autotel/prototype-physical-modular/datasheets and references/F1752AGIJYUVVP0.png

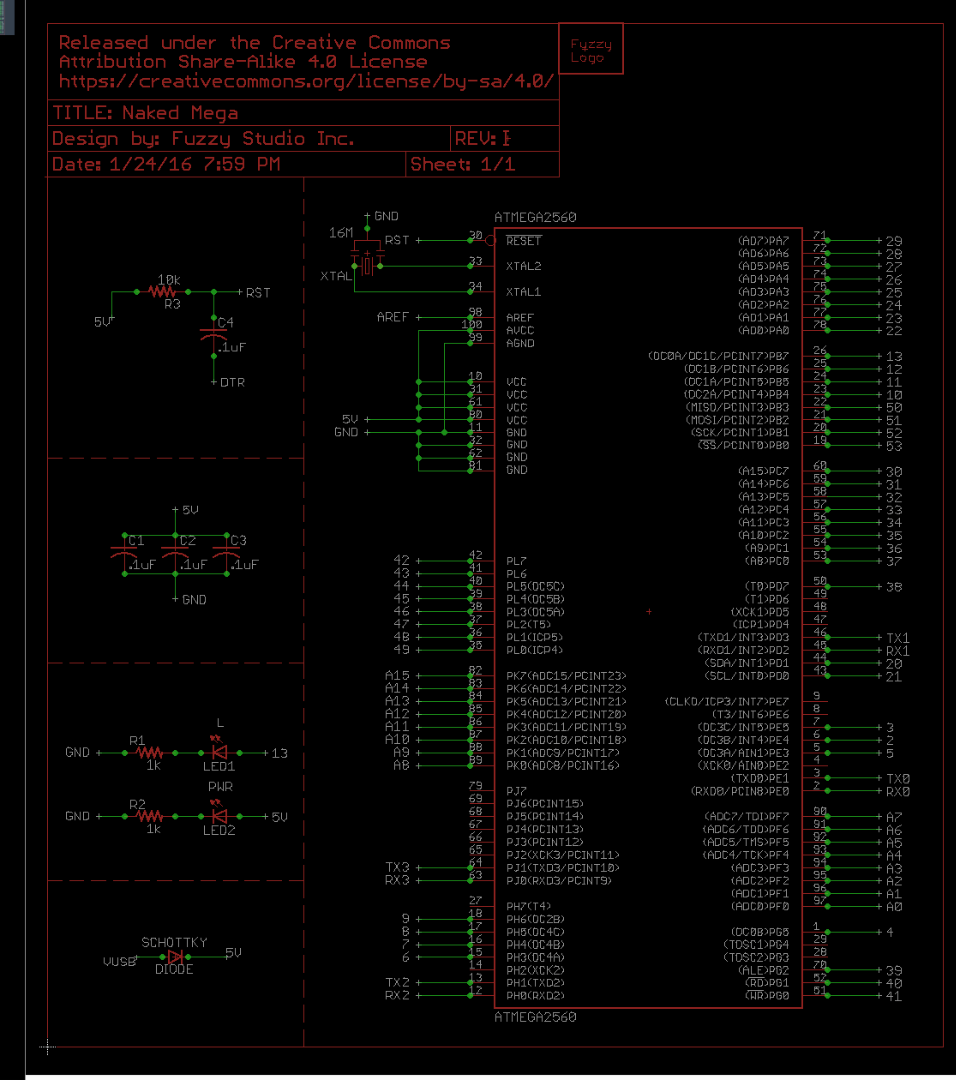
datasheets and references/F1752AGIJYUVVP0.png
