autotel/prototype-physical-modular/3d models/WS2812_RGB_LED_updated.stp

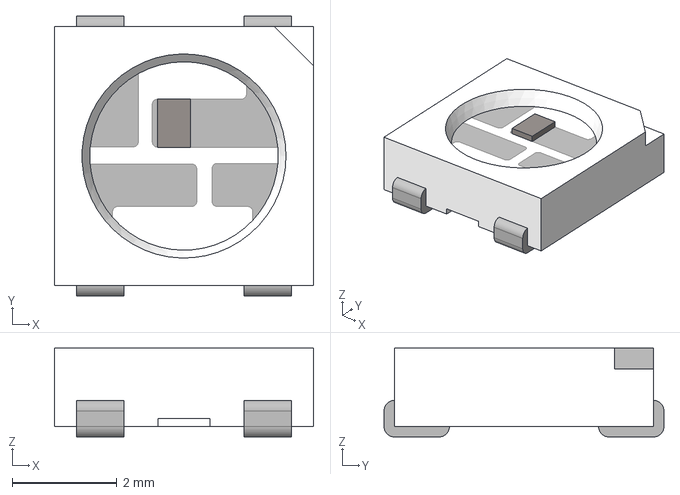
[picture p2: CAD file, 2017-10-20]
3d models/WS2812_RGB_LED_updated.stp
4.95 x 5.35 x 1.70 mm
