autotel/prototype-physical-modular/datasheets and references/under with raspi.dxf

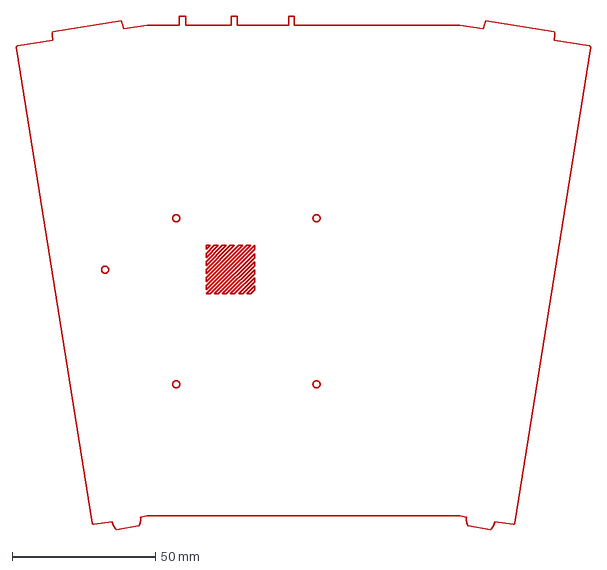
[picture p3: CAD file, 2017-09-11]
datasheets and references/under with raspi.dxf
200.6 x 179.2 mm
