autotel/prototype-physical-modular/enclosure/print/translucid.dxf

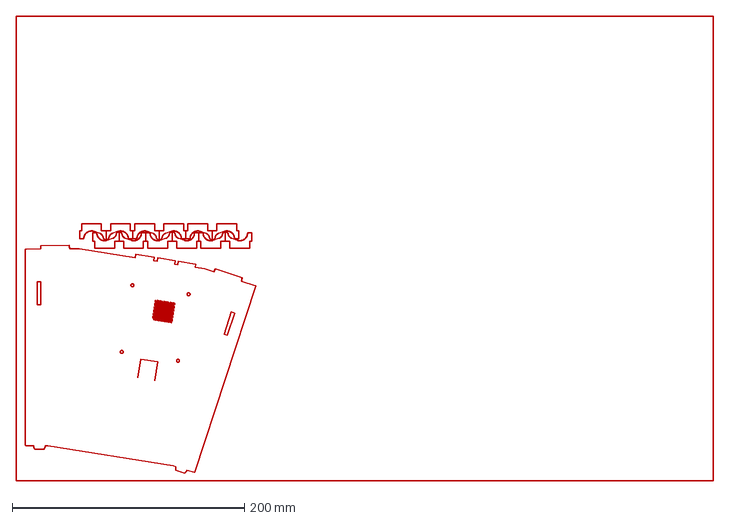
[picture p4: CAD file, 2018-03-19]
enclosure/print/translucid.dxf
600.0 x 400.0 mm
