autotel/prototype-physical-modular/enclosure/simpler enclosure 2017-11-23.dxf

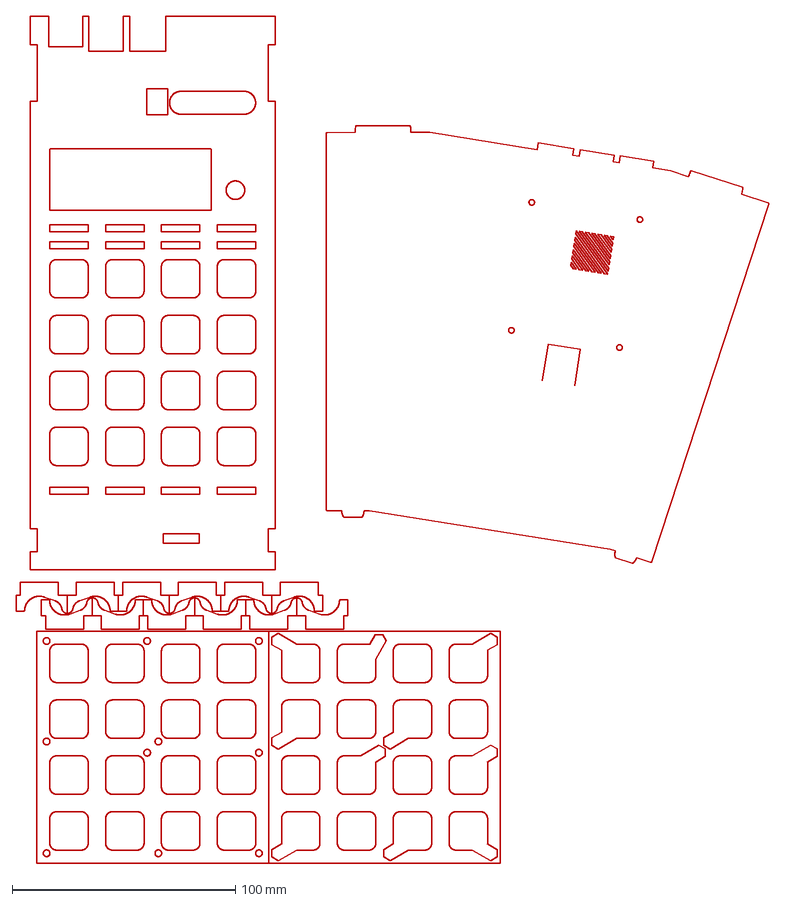
[picture p5: CAD file, 2018-03-19]
enclosure/simpler enclosure 2017-11-23.dxf
336.8 x 379.1 mm
