autotel/prototype-physical-modular/prints/prototype-physical modular-F.Cu.dxf

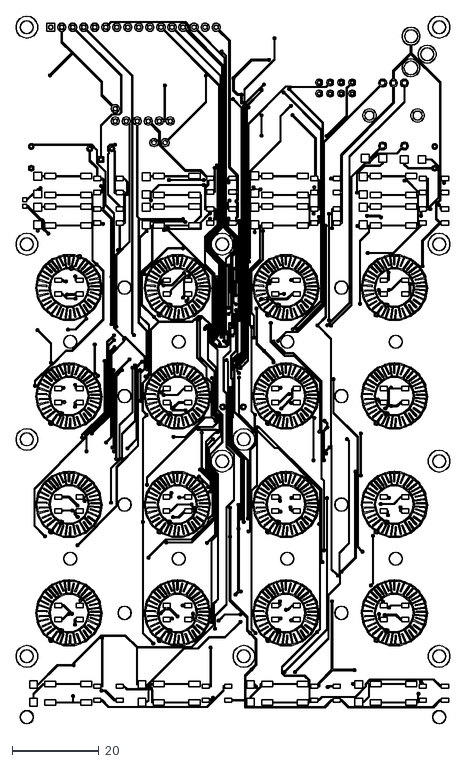
[picture p6: CAD file, 2018-03-19]
prints/prototype-physical modular-F.Cu.dxf
99.9 x 163.0
