autotel/prototype-physical-modular/datasheets and references/Raspberry-Pi-3B-V1.2-Mechanical.dxf

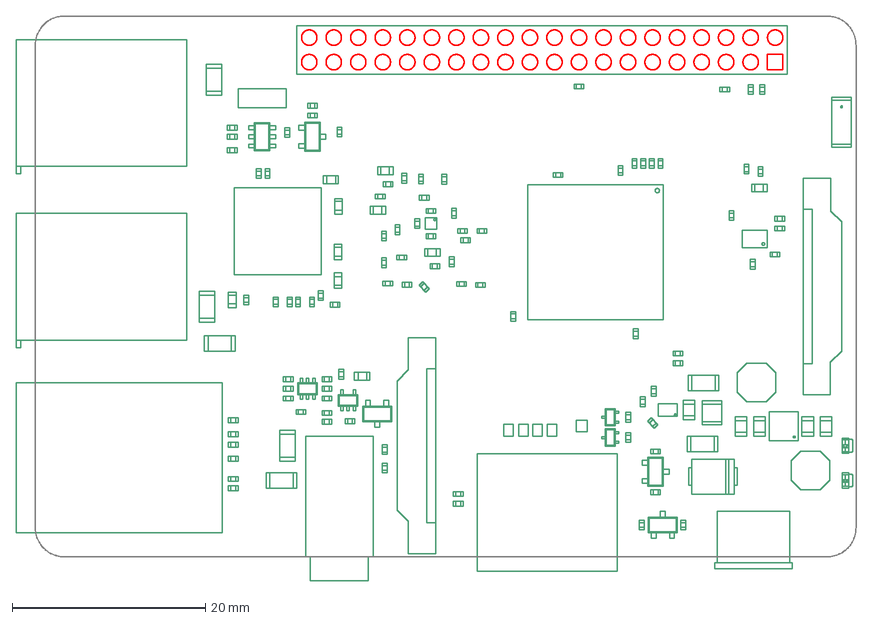
[picture p7: CAD file, 2017-06-26]
datasheets and references/Raspberry-Pi-3B-V1.2-Mechanical.dxf
87.0 x 58.5 mm
