autotel/prototype-physical-modular/enclosure/print/knob.stl

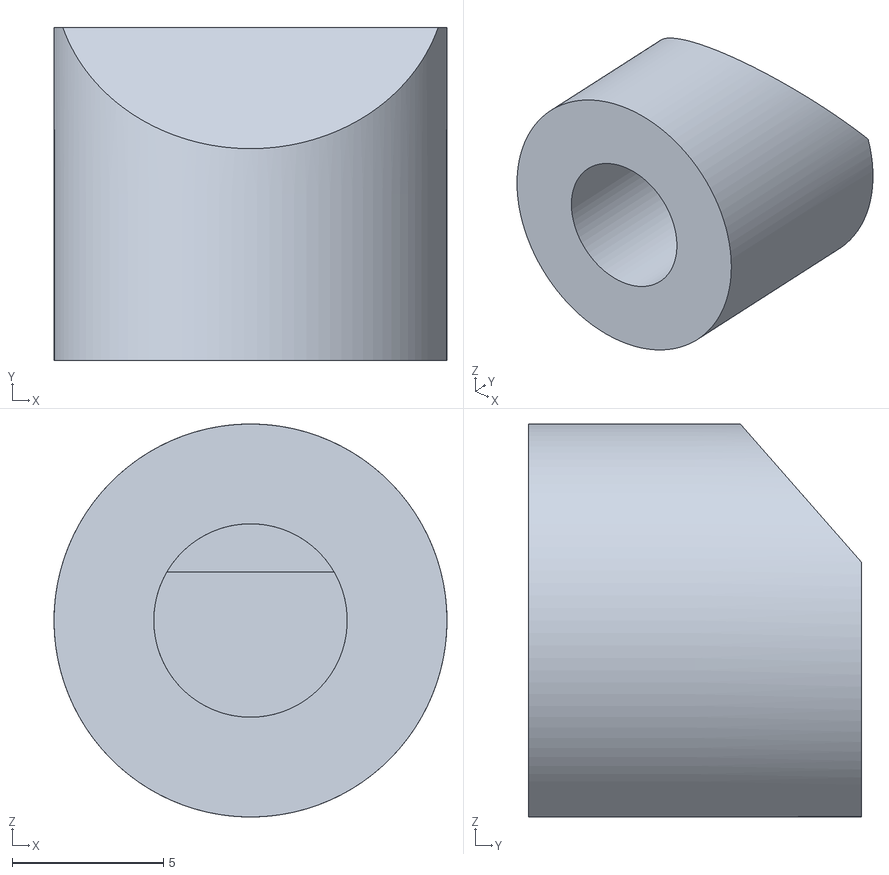
[picture p8: CAD file, 2018-03-19]
enclosure/print/knob.stl
13.0 x 11.0 x 13.0
