autotel/prototype-physical-modular/prints/prototype-physical modular-Edge.Cuts.dxf

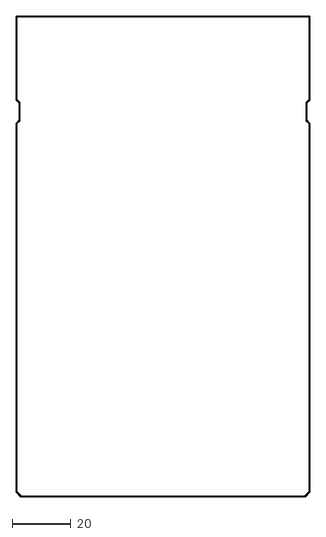
[picture p9: CAD file, 2018-03-19]
prints/prototype-physical modular-Edge.Cuts.dxf
100.2 x 164.1
