autotel/prototype-physical-modular/datasheets and references/SKQGWith stem type pad sizes.dxf

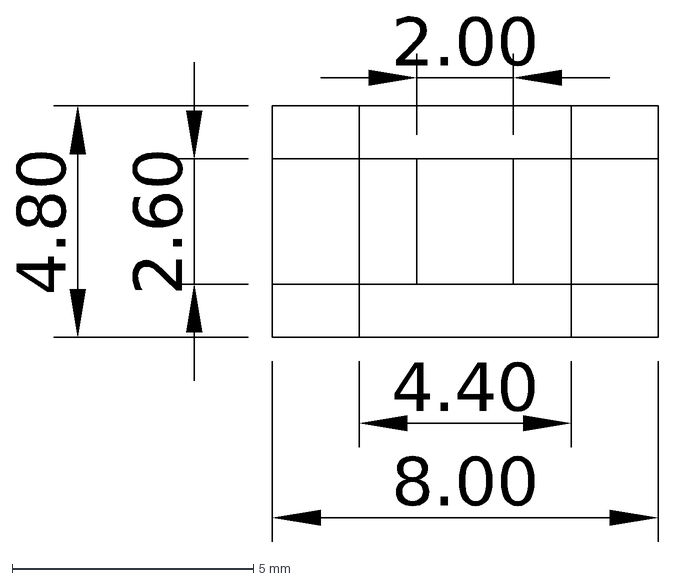
[picture p10: CAD file, 2017-06-26]
datasheets and references/SKQGWith stem type pad sizes.dxf
2.00
8.00
4.80
2.60
4.40
