autotel/prototype-physical-modular/enclosure/print/opaque.dxf

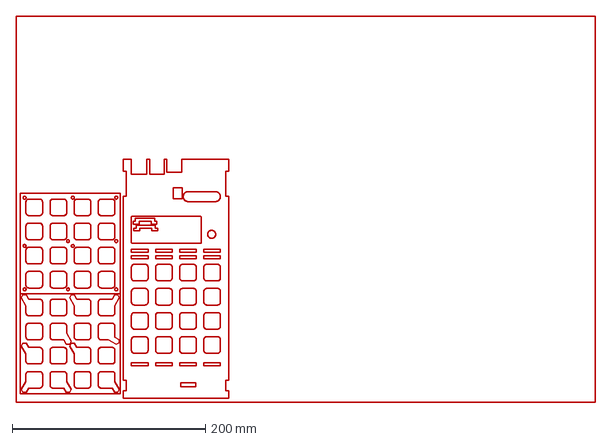
[picture p11: CAD file, 2018-03-19]
enclosure/print/opaque.dxf
600.0 x 400.0 mm
