autotel/prototype-physical-modular/prints/prototype-physical modular-B.Cu.dxf

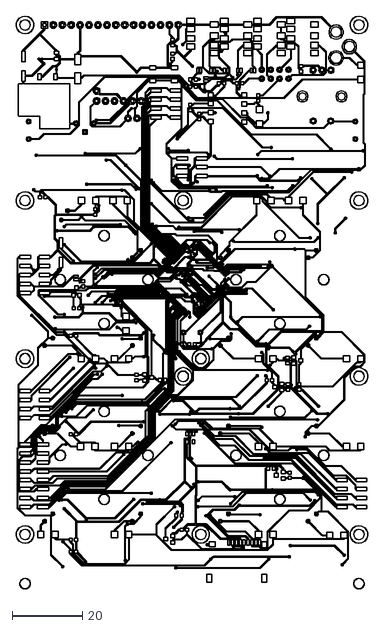
[picture p12: CAD file, 2018-03-19]
prints/prototype-physical modular-B.Cu.dxf
99.9 x 163.0
