autotel/prototype-physical-modular/enclosure/print/opaque_front.dxf

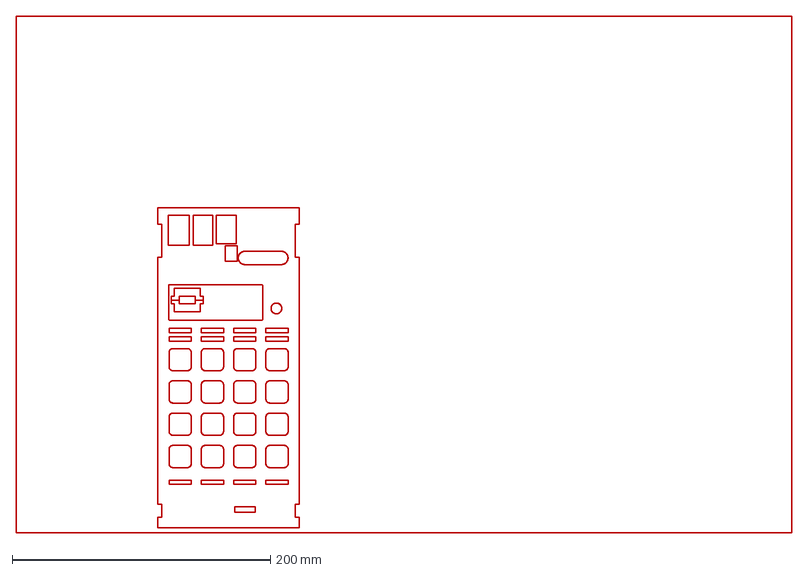
[picture p13: CAD file, 2018-03-19]
enclosure/print/opaque_front.dxf
600.0 x 400.0 mm
