autotel/prototype-physical-modular/(list of files, cad)

Other CAD files:
3d models/WS2812_RGB_LED_Updated.igs
3d models/WS2812b Updated.prt
3d models/WS2812b updated.x_t
datasheets and references/raspi.3dm
enclosure/OldVersions/knob.0003.ipt
enclosure/acrylic bending curve calculation.3dm
enclosure/knob.ipt
prints/prototype-physical modular-B.Mask.dxf
prints/prototype-physical modular-F.Mask.dxf
prints/prototype-physical modular-F.SilkS.dxf
