autotel/prototype-physical-modular/enclosure/cotizacion joaquin.pdf

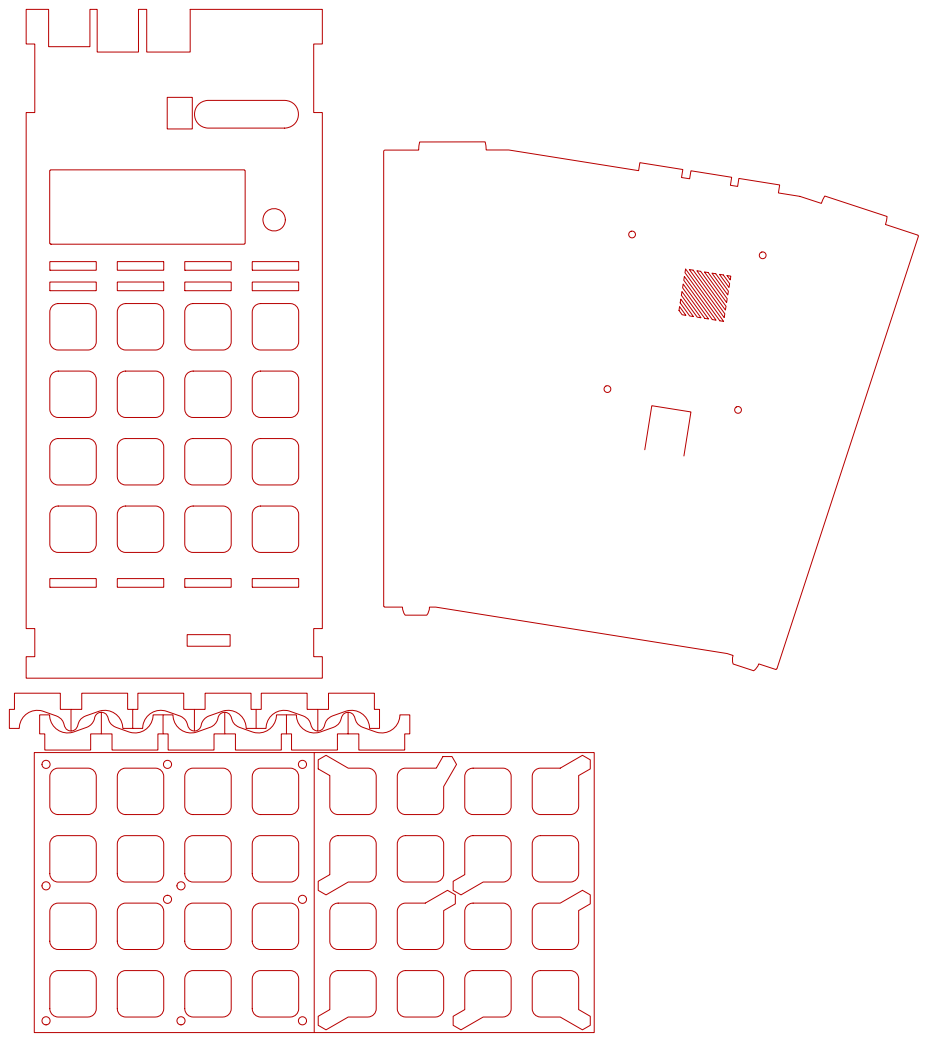
[picture p14: page 1]
