autotel/prototype-physical-modular/enclosure/simpler enclosure-cotizacion.pdf

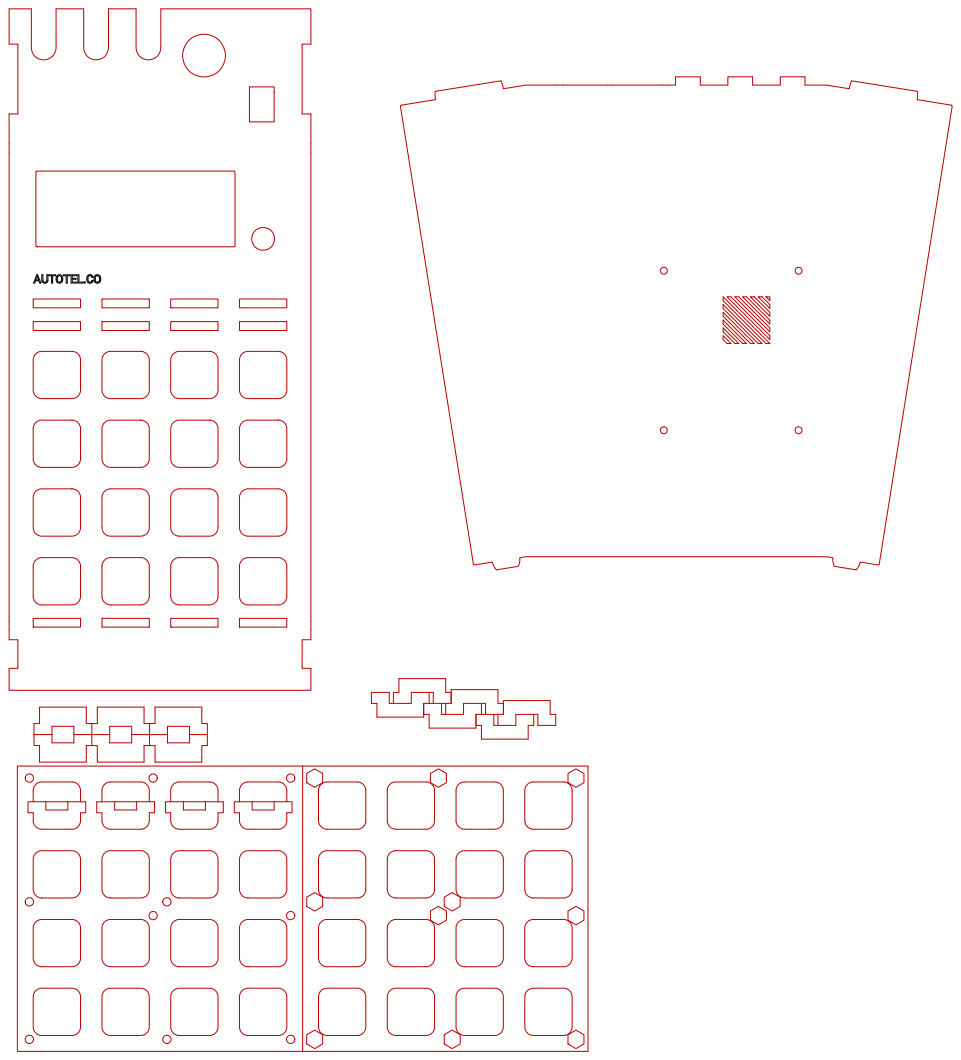
[picture p15: page 1]
