autotel/prototype-physical-modular/(list of files, drawings)

Other design files:
353-122283914449.dsn
prototype-physical modular.dsn
specctra-305-107207415804.dsn
unrouted.dsn
