autotel/prototype-physical-modular/prototype-physical modular.kicad_pcb

## KiCad design prototype-physical modular.kicad_pcb (2018-03-19)

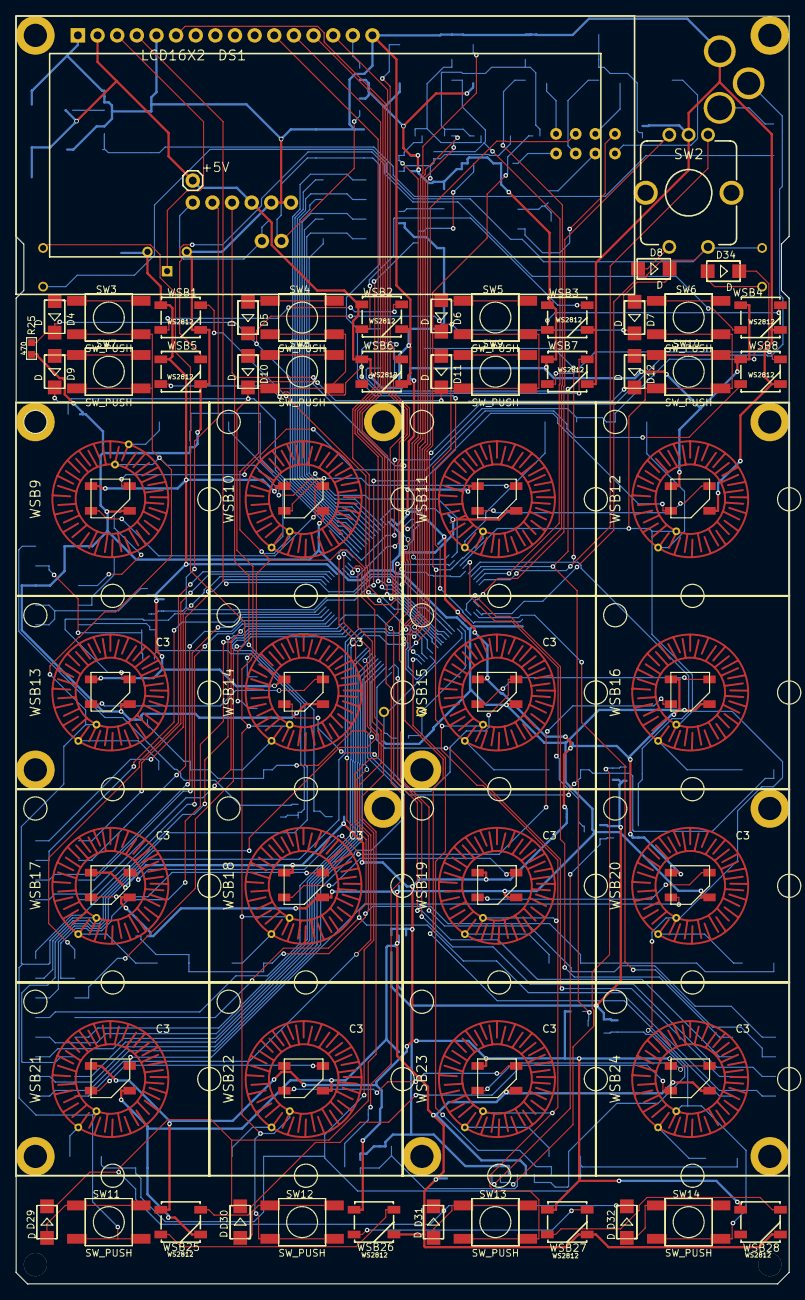
[picture p16: board prototype-physical modular.kicad_pcb from above]

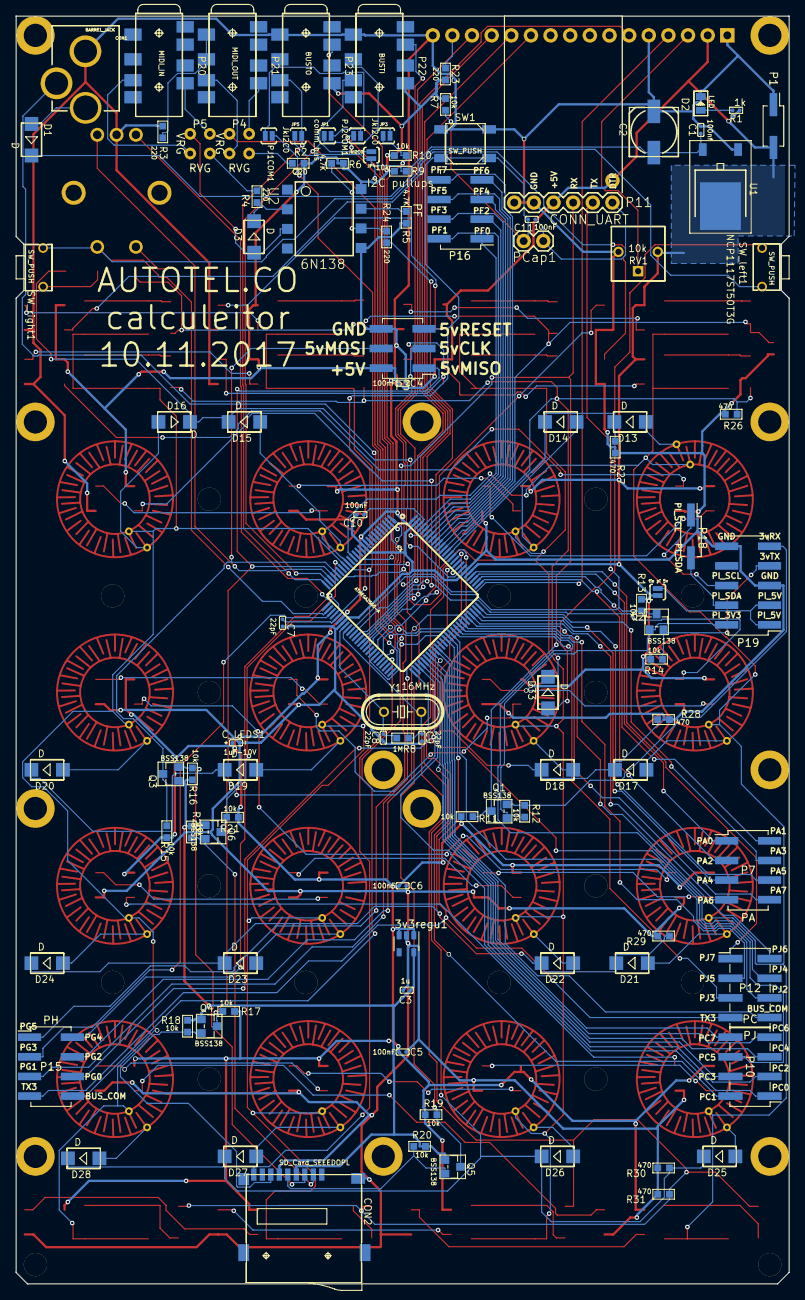
[picture p17: board prototype-physical modular.kicad_pcb from below]

Board: 2 copper layers, 100.0 x 164.0 mm, 188 parts (103 on the bottom side), 168 nets.

Parts:
3v3regu1: TLV70233DBV; SOT-23-5
+5V: >VALUE; 1X01
C1: 100nf; C0402
C2: Aluminum 47uF-25V; ELECTRO-SMD-C-6MM
C3: 1u; C0402
C4, C5, C6, C10, C11: 100nF; C0402
C7, C8, C9: 22pF; C0402
CON1: BARREL_JACK; POWER_JACK_PTH_LOCK
CON2: SD_Card_SEEEDOPL; MICRO-SD9+4P-SMD-16.1X14.5X1.85MM
C_LEDS1: 1uF-10V; C0402_electrolitic
D1, D3, D4, D5, D6, D7, D8, D9, D10, D11, D12, D13, D14, D15, D16, D17, D18, D19, D20, D21, D22, D23, D24, D25, D26, D27, D28, D29, D30, D31, D32, D33, D34: D; DO-214AC
D2: LED; LED-0805
DS1: LCD16X2; LCD-16X2
H1, H2, H3, H4, H5, H6, H7, H8, H9, H10, H11, H12, H26, H27, H28, H29, H30: hole; hole_no-copper
H13, H14, H15, H16, H18, H20, H21, H22, H23, H24: hole; hole_with-copper
IC1: ATMEGA2560-A; TQFP100
JP1: comm_bus; PAD-JUMPER-2-NO_YES_SILK
JP2: tie pi 5v; PAD-JUMPER-2-NO_YES_SILK
JP3, JP4, JP5: JkI2C0; PAD-JUMPER-2-NO_YES_SILK
P1: POWER; Pin_Header_Straight_2x01_Pitch2.54mm_SMD
P3: SPI; Pin_Header_Straight_2x03_Pitch2.54mm_SMD
P4, P5: CONN_02X02; xjump
P7: PA; Pin_Header_Straight_2x04_Pitch2.54mm_SMD
P10: PC; Pin_Header_Straight_2x04_Pitch2.54mm_SMD
P11: CONN_UART; 1X06
P12: PJ; Pin_Header_Straight_2x04_Pitch2.54mm_SMD
P15: PH; Pin_Header_Straight_2x04_Pitch2.54mm_SMD
P16: PF; Pin_Header_Straight_2x04_Pitch2.54mm_SMD
P18: 3VI2C; Pin_Header_Straight_2x01_Pitch2.54mm_SMD
P19: PIGPIO; Pin_Header_Straight_2x05_Pitch2.54mm_SMD-raspi
P20: MIDI_IN; AUDIO8P-SMD-3.5-14.5X6.1X4.0MM
P21: MIDI_OUT; AUDIO8P-SMD-3.5-14.5X6.1X4.0MM
P22: BUSTI; AUDIO8P-SMD-3.5-14.5X6.1X4.0MM
P23: BUSTO; AUDIO8P-SMD-3.5-14.5X6.1X4.0MM
PCap1: CONN_01X02; 1X02
PJ1COM1, PJ2COM1: Jumper_NO_Small; PAD-JUMPER-2-NO_YES_SILK
Q1, Q2, Q3, Q4, Q5, Q6: BSS138; SOT-23
R1: 1k; R0402
R2, R3, R4, R23, R24: 220; R0603
R5, R6: 4.7K; R0603
R7, R9, R10, R11, R12, R13, R14, R15, R16, R17, R18, R19, R20, R21, R22: 10k; R0603
R8: 1M; R0603
R25, R26, R27, R28, R29, R30, R31: 470; R0603
RV1: 10k; trimpot
SW1: SW_PUSH; SW4-SMD-5.2X5.2X1.5MM
SW2: ROTARY_ENCODER_SWITCH; ENCODER_LED_2
SW3, SW4, SW5, SW6, SW7, SW8, SW9, SW10, SW11, SW12, SW13, SW14: SW_PUSH; SW4-SMD-6.0X6.0X5.0MM
SW_left1: SW_PUSH; SW2-5.0-6.0X3.0X4.3MM
SW_right1: SW_PUSH; SW2-5.0-6.0X3.0X4.3MM
U1: NCP1117ST50T3G; TO-252
U2: 6N138; 8-SMD
WSB1, WSB2, WSB3, WSB4, WSB5, WSB6, WSB7, WSB8, WSB25, WSB26, WSB27, WSB28: WS2812; WS2812B
WSB9, WSB10, WSB11, WSB12, WSB13, WSB14, WSB15, WSB16, WSB17, WSB18, WSB19, WSB20, WSB21, WSB22, WSB23, WSB24: WS2812_BUTTON; ws2812_buttonPad
Y1: 16MHz; HC49US

Connections:
+3V3: 3v3regu1.5, C3.1, CON2.4, Q3.1, Q4.1, Q5.1, Q6.1, R16.1, R18.1, R20.1, R22.1
+5V: 3v3regu1.1, 3v3regu1.3, +5V.1, C4.1, C5.1, C6.1, C_LEDS1.1, DS1.2, IC1.10, IC1.31, IC1.80, IC1.100, JP2.2, P1.2, P3.2, P11.3, P22.4, P23.4, R1.1, R2.1, R6.2, R7.1, R9.1, R10.1, R11.2, R13.2, R15.2, R17.2, R19.2, R21.2, R23.1, RV1.1, U1.2, U2.8, WSB1.1, WSB2.1, WSB3.1, WSB4.1, WSB5.1, WSB6.1, WSB7.1, WSB8.1, WSB9.1, WSB10.1, WSB11.1, WSB12.1, WSB13.1, WSB14.1, WSB15.1, WSB16.1, WSB17.1, WSB18.1, WSB19.1, WSB20.1, WSB21.1, WSB22.1, WSB23.1, WSB24.1, WSB25.1, WSB26.1, WSB27.1, WSB28.1
/3VSD_CS: CON2.2, Q6.2, R22.2
/3vRX0: P19.9, Q1.2, R12.2
/3vSPI_MISO: CON2.7, Q4.2, R18.2
/3vSPI_MOSI: CON2.3, Q3.2, R16.2
/3vSPI_SCK: CON2.5, Q5.2, R20.2
/3vTX0: P19.7, Q2.2, R14.2
/5VSD_CLK: IC1.20, P3.3, Q5.3, R19.1
/5VSD_CS: IC1.19, Q6.3, R21.1
/5VSD_MISO: IC1.22, P3.1, Q4.3, R17.1
/5VSD_MOSI: IC1.21, P3.4, Q3.3, R15.1
/BUSTI_CONN: IC1.82, P22.6
/BUSTO_CONN: IC1.14, P23.6
/BUS_COM: IC1.63, JP1.1, JP3.2, P12.8, P15.8, P22.2
/BUS_COM_B: JP1.2, P23.2, PJ1COM1.1, PJ2COM1.1
/BUS_TI: IC1.24, JP4.2, P22.3
/BUS_TO: IC1.25, JP5.2, P23.3
/DTR: C11.1, P11.6, PCap1.2
/ENCA: IC1.23, SW2.A
/ENCC: IC1.26, SW2.B
/LCD0: DS1.4, IC1.35
/LCD1: DS1.6, IC1.36
/LCD2: DS1.11, IC1.37
/LCD3: DS1.12, IC1.38
/LCD4: DS1.13, IC1.39
/LCD5: DS1.14, IC1.40
/MIDI_IN_RX_PRE: D3.+, P5.3, U2.3
/MIDI_OUT_TX: IC1.46, P4.3
/MIDI_RX: IC1.45, R24.2
/MUXAX0: IC1.15, SW3.2, SW7.2, SW11.2, WSB9.6, WSB13.6, WSB17.6, WSB21.6
/MUXAX1: IC1.16, SW4.2, SW8.2, SW12.2, WSB10.6, WSB14.6, WSB18.6, WSB22.6
/MUXAX2: IC1.17, SW5.2, SW9.2, SW13.2, WSB11.6, WSB15.6, WSB19.6, WSB23.6
/MUXAX3: IC1.18, SW6.2, SW10.2, SW14.2, WSB12.6, WSB16.6, WSB20.6, WSB24.6
/MUXAX4: IC1.27, SW2.D, SW_left1.2, SW_right1.2
/MUXBX0: D4.-, D5.-, D6.-, D7.-, D8.-, IC1.89, R25.2
/MUXBX1: D9.-, D10.-, D11.-, D12.-, D33.-, IC1.88, R26.2
/MUXBX2: D13.-, D14.-, D15.-, D16.-, D34.-, IC1.87, R27.2
/MUXBX3: D17.-, D18.-, D19.-, D20.-, IC1.86, R28.2
/MUXBX4: D21.-, D22.-, D23.-, D24.-, IC1.85, R29.1
/MUXBX5: D25.-, D26.-, D27.-, D28.-, IC1.84, R30.1
/MUXBX6: D29.-, D30.-, D31.-, D32.-, IC1.83, R31.1
/PI5vRX0: IC1.2, P11.4, Q1.3, R11.1
/PI5vTX0: IC1.3, P11.5, Q2.3, R13.1
/PI_3V3: P19.2, Q1.1, Q2.1, R12.1, R14.1
/PI_5V: JP2.1, P19.1, P19.3
/PI_SCL: P18.1, P19.6
/PI_SDA: P18.2, P19.4
/POWER_IS: CON1.GNDB, IC1.50
/RESET: C7.1, C11.2, IC1.30, P3.5, PCap1.1, R7.2, SW1.2
/SCL: IC1.43, JP4.1, JP5.1, R9.2
/SDA: IC1.44, JP3.1, R10.2
/SD_CDetc: CON2.9, IC1.47
/SERIAL_LED_PIN: IC1.41, WSB1.4
/SERIAL_LED_TOROW_1: WSB4.2, WSB5.4
/SERIAL_LED_TOROW_2: WSB8.2, WSB9.4
/SERIAL_LED_TOROW_3: WSB12.2, WSB13.4
/SERIAL_LED_TOROW_4: WSB16.2, WSB17.4
/SERIAL_LED_TOROW_5: WSB20.2, WSB21.4
/SERIAL_LED_TOROW_6: WSB24.2, WSB25.4
/TX3: IC1.64, P12.7, P15.7, PJ1COM1.2
GND: 3v3regu1.2, C1.2, C2.+, C3.2, C4.2, C5.2, C6.2, C7.2, C8.2, C9.2, C10.2, CON1.GND, CON2.6, CON2.G4, C_LEDS1.2, D2.-, DS1.1, DS1.5, DS1.16, IC1.11, IC1.32, IC1.81, IC1.99, P1.1, P3.6, P11.1, P11.2, P19.5, P19.10, P22.1, P23.1, R3.2, R5.1, R25.1, R26.1, R27.1, R28.1, R29.2, R30.2, R31.2, RV1.3, SW1.1, SW2.C, U1.1, U2.5, WSB1.3, WSB2.3, WSB3.3, WSB4.3, WSB5.3, WSB6.3, WSB7.3, WSB8.3, WSB9.3, WSB10.3, WSB11.3, WSB12.3, WSB13.3, WSB14.3, WSB15.3, WSB16.3, WSB17.3, WSB18.3, WSB19.3, WSB20.3, WSB21.3, WSB22.3, WSB23.3, WSB24.3, WSB25.3, WSB26.3, WSB27.3, WSB28.3
unnamed: C1.1, C2.-, D1.-, U1.3
unnamed: C8.1, IC1.33, R8.1, Y1.1
unnamed: C9.1, IC1.34, R8.2, Y1.2
unnamed: C10.1, IC1.98
unnamed: CON1.PWR, D1.+
unnamed: D2.+, R1.2
unnamed: D3.-, R4.2, U2.2
unnamed: D4.+, SW3.1
unnamed: D5.+, SW4.1
unnamed: D6.+, SW5.1
unnamed: D7.+, SW6.1
unnamed: D8.+, SW2.E
unnamed: D9.+, SW7.1
unnamed: D10.+, SW8.1
unnamed: D11.+, SW9.1
unnamed: D12.+, SW10.1
unnamed: D13.+, WSB9.5
unnamed: D14.+, WSB10.5
unnamed: D15.+, WSB11.5
unnamed: D16.+, WSB12.5
unnamed: D17.+, WSB13.5
unnamed: D18.+, WSB14.5
unnamed: D19.+, WSB15.5
unnamed: D20.+, WSB16.5
unnamed: D21.+, WSB17.5
unnamed: D22.+, WSB18.5
unnamed: D23.+, WSB19.5
unnamed: D24.+, WSB20.5
unnamed: D25.+, WSB21.5
unnamed: D26.+, WSB22.5
unnamed: D27.+, WSB23.5
unnamed: D28.+, WSB24.5
unnamed: D29.+, SW11.1
unnamed: D30.+, SW12.1
unnamed: D31.+, SW13.1
unnamed: D32.+, SW14.1
unnamed: D33.+, SW_left1.1
unnamed: D34.+, SW_right1.1
unnamed: DS1.3, RV1.2
unnamed: DS1.15, R23.2
unnamed: IC1.1, P15.1
unnamed: IC1.28, P15.3
unnamed: IC1.29, P15.2
unnamed: IC1.51, P15.6
unnamed: IC1.52, P15.5
unnamed: IC1.53, P10.1
unnamed: IC1.54, P10.2
unnamed: IC1.55, P10.3
unnamed: IC1.56, P10.4
unnamed: IC1.57, P10.5
unnamed: IC1.58, P10.6
unnamed: IC1.59, P10.7
unnamed: IC1.60, P10.8
unnamed: IC1.65, P12.6, PJ2COM1.2
unnamed: IC1.66, P12.5
unnamed: IC1.67, P12.4
unnamed: IC1.68, P12.3
unnamed: IC1.69, P12.2
unnamed: IC1.70, P15.4
unnamed: IC1.71, P7.8
unnamed: IC1.72, P7.7
unnamed: IC1.73, P7.6
unnamed: IC1.74, P7.5
unnamed: IC1.75, P7.4
unnamed: IC1.76, P7.3
unnamed: IC1.77, P7.2
unnamed: IC1.78, P7.1
unnamed: IC1.79, P12.1
unnamed: IC1.90, P16.8
unnamed: IC1.91, P16.7
unnamed: IC1.92, P16.6
unnamed: IC1.93, P16.5
unnamed: IC1.94, P16.4
unnamed: IC1.95, P16.3
unnamed: IC1.96, P16.2
unnamed: IC1.97, P16.1
unnamed: P4.2, R2.2
unnamed: P5.2, R4.1
unnamed: P5.4, P20.3
unnamed: P5.1, P20.4
unnamed: P21.1, P21.2, R3.1
unnamed: P4.4, P21.3
unnamed: P4.1, P21.4
unnamed: R5.2, U2.7
unnamed: R6.1, R24.1, U2.6
unnamed: WSB1.2, WSB2.4
unnamed: WSB2.2, WSB3.4
unnamed: WSB3.2, WSB4.4
unnamed: WSB5.2, WSB6.4
unnamed: WSB6.2, WSB7.4
unnamed: WSB7.2, WSB8.4
unnamed: WSB10.2, WSB11.4
unnamed: WSB9.2, WSB10.4
unnamed: WSB11.2, WSB12.4
unnamed: WSB13.2, WSB14.4
unnamed: WSB14.2, WSB15.4
unnamed: WSB15.2, WSB16.4
unnamed: WSB17.2, WSB18.4
unnamed: WSB18.2, WSB19.4
unnamed: WSB19.2, WSB20.4
unnamed: WSB21.2, WSB22.4
unnamed: WSB22.2, WSB23.4
unnamed: WSB23.2, WSB24.4
unnamed: WSB25.2, WSB26.4
unnamed: WSB26.2, WSB27.4
unnamed: WSB27.2, WSB28.4
