autotel/prototype-physical-modular/firmware/helloWS2812-alt/helloWS2812-alt.ino

// Use if you want to force the software SPI subsystem to be used for some reason (generally, you don't)
// #define FASTLED_FORCE_SOFTWARE_SPI
// Use if you want to force non-accelerated pin access (hint: you really don't, it breaks lots of things)
// #define FASTLED_FORCE_SOFTWARE_SPI
// #define FASTLED_FORCE_SOFTWARE_PINS
#include "FastLED.h"

#define NUM_LEDS 28
#define DATA_PIN 43
CRGB leds[NUM_LEDS];
void setup() {
  // sanity check delay - allows reprogramming if accidently blowing power w/leds
  delay(2000);
  FastLED.addLeds<WS2811, DATA_PIN, RGB>(leds, NUM_LEDS);
}
void loop() {
  for (int whiteLed = 0; whiteLed < NUM_LEDS; whiteLed = whiteLed + 1) {
    leds[whiteLed] = CRGB::White;
    FastLED.show();
    delay(100);
    leds[whiteLed] = CRGB::Black;
  }
}
