autotel/prototype-physical-modular/(commit log)

2017-06-20 communication test firmwares and bare minimum atmega 2560 kicad shcematic
    [prototype-physical modular.kicad_pcb, prototype-physical modular.sch]
2017-06-20 forward with schematic added buttons, power, arduino pro mini interface, communication and midi interconnectors, screen & encoder
    [prototype-physical modular.sch]
2017-06-21 schematic finished, subject to revisons added sd card, diodes in matrix, 3v3 voltage, modular headers fo Mega. test of button matrix that revealed need for diodes
    [prototype-physical modular.sch]
2017-06-21 localize search for schematic component libraries
    [prototype-physical modular.sch]
2017-06-21 assign seeedstudio parts sku and footprints where available
    [prototype-physical modular.sch]
2017-06-22 made footprints for ws2812's with button replaced schematic symbols for the buttons that use tacht switches
    [prototype-physical modular.kicad_pcb, prototype-physical modular.sch]
2017-06-22 fill components metadata
    [prototype-physical modular.sch]
2017-06-22 solving errors, placing elements in pcb
    [prototype-physical modular.kicad_pcb, prototype-physical modular.sch]
2017-06-22 fix more mistakes, forward with pcblayout
    [prototype-physical modular.kicad_pcb, prototype-physical modular.sch]
2017-06-22 fix more errors, advance more in pcb layout
    [_saved_prototype-physical modular.sch, prototype-physical modular.kicad_pcb]
2017-06-23 fix one connection mistake, forward trying to route pcb
    [_saved_prototype-physical modular.sch, prototype-physical modular.dsn, prototype-physical modular.kicad_pcb, prototype-physical modular.sch]
2017-06-23 fixed diode footprints were wrong polarity. forward with routing
    [prototype-physical modular.csv, prototype-physical modular.dsn, prototype-physical modular.kicad_pcb]
2017-06-23 MUXACOM not necessary
    [_saved_prototype-physical modular.sch, prototype-physical modular.kicad_pcb]
2017-06-23 netlist was being saved on wrong name
    [_saved_prototype-physical modular.sch, prototype-physical modular.dsn, prototype-physical modular.kicad_pcb]
2017-06-23 still trying to make it routable
    [_saved_prototype-physical modular.sch, prototype-physical modular.dsn, prototype-physical modular.kicad_pcb, prototype-physical modular.sch]
2017-06-26 -fix mistakes -fix wrong tact switches autorouter and manual router
    [SKQGWith stem type pad sizes.dxf, prototype-physical modular.dsn, prototype-physical modular.kicad_pcb, prototype-physical modular.sch]
2017-06-26 managed to autoroute
    [Raspberry-Pi-3B-V1.2-Mechanical.dxf, prototype-physical modular.dsn, prototype-physical modular.kicad_pcb, prototype-physical modular.sch, raspi.3dm]
2017-06-27 corrected optocoupler connections, sorted labels, optimization of placement
    [_saved_prototype-physical modular.sch, prototype-physical modular.dsn, prototype-physical modular.kicad_pcb, prototype-physical modular_extreme.dsn]
2017-06-28 pot had wrong pins forward with pcb design
    [BOM.ods, _saved_prototype-physical modular.sch, prototype-physical modular.csv, prototype-physical modular.dsn, prototype-physical modular.kicad_pcb, prototype-physical modular.sch, specctra-305-107207415804.dsn]
2017-06-28 create bom while routing
    [BOM.ods, BOM_seeed.xls, prototype-physical modular.dsn, prototype-physical modular.sch, unrouted.dsn]
2017-06-28 Add I2C enabling Jumpers testing and beefing up TBN communication different arrangement try in PCB
    [353-122283914449.dsn, prototype-physical modular.dsn, prototype-physical modular.kicad_pcb, prototype-physical modular.sch, prototype-physical modular_extreme.dsn]
2017-07-04 - testing communications with all the rest of the hardware - spotted wrongly connected CS pin for SD card
    [prototype-physical modular.dsn, prototype-physical modular.kicad_pcb, prototype-physical modular.sch]
2017-07-07 remap pins in prototype tests, and changed TIP and TOP pins in schematic
    [prototype-physical modular.kicad_pcb, prototype-physical modular.sch]
2017-07-16 correction of BOM and routing
    [BOM_seeed.xls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]
2017-09-11 correct wrong part number in midi inputs & outputs
    [BOM.ods, prototype-physical modular.sch]
2017-09-11 update gerbers
    [BOM_seeed.xls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]
2017-09-25 annotation of some mistakes in board
    [prototype-physical modular.kicad_pcb]
2017-09-27 try measuring buttons with inverted register roles (are diodes the wrong way?)
    [helloButtons.ino]
2017-09-27 tested with inverted roles it works, but there is an obvious need for pullup or pulldown, all non pressed buttons are erratic
    [helloButtons.ino]
2017-09-27 figured out the buttons algorhythm
2017-09-27 analog read of the buttons. quite bad on this hardware configuration
2017-09-27 digital read not working?
    [helloButtons.ino]
2017-10-02 started working on minimum sequencer
    [prototype-physical modular.sch]
2017-10-10 create firmware that would run in my node virtual modular interface. It has some memory leak note about the encoder in schematic for next production
    [prototype-physical modular.sch]
2017-10-12 slower baud rate more stability in v2 finetuning and general mingling about firmware
    [prototype-physical modular.sch]
2017-10-20 two: connect encoder and remove arduino pro mini in schematic controllerfirmware: improve encoder steps counting
    [prototype-physical modular.sch]
2017-10-20 test and add pulldowns for buttons
    [prototype-physical modular.kicad_pcb, prototype-physical modular.sch]
2017-10-20 use lower resistor pulldown
    [prototype-physical modular.sch]
2017-10-20 flip bus with +5V pins in the BUSTO &BUSTI plugs otherwise, it does a shortcircuit sometimes when plugging the jack in.
    [prototype-physical modular.kicad_pcb, prototype-physical modular.sch]
2017-10-20 reflect schematic changes on board
    [WS2812_RGB_LED_Updated.igs, WS2812_RGB_LED_updated.stp, WS2812b Updated.prt, WS2812b updated.x_t, prototype-physical modular.kicad_pcb]
2017-10-20 button matrix diodes needed to be inverse
    [prototype-physical modular.dsn, prototype-physical modular.kicad_pcb, prototype-physical modular.sch]
2017-10-21 fix sd card pins were catastrophically wrong still figuring out layout
    [prototype-physical modular.dsn, prototype-physical modular.kicad_pcb, prototype-physical modular.sch]
2017-10-21 more layout, inclusion of enclosure design
    [acrylic bending curve calculation.3dm, knob.0003.ipt, knob.ipt, knob.stl, prototype-physical modular.dsn, prototype-physical modular.kicad_pcb, prototype-physical modular.sch]
2017-10-21 fix wrong midi jack plug
    [prototype-physical modular.kicad_pcb, prototype-physical modular.sch]
2017-10-21 fix the swap of bus jacks that was done wrong
    [prototype-physical modular.sch]
2017-10-23 change name of CD sd
    [prototype-physical modular.sch]
2017-10-31 correction of buttonmap
2017-11-02 flip FTDI to correct side, draw size fro better fit with enclosure & many others
    [prototype-physical modular.dsn, prototype-physical modular.kicad_pcb, prototype-physical modular.sch]
2017-11-08 select better tact switches, add holes in the schematic to avoid future problems
    [_saved_prototype-physical modular.sch, prototype-physical modular.dsn, prototype-physical modular.kicad_pcb]
2017-11-08 last commit
    [_saved_prototype-physical modular.sch, prototype-physical modular.sch]
2017-11-08 modularized development of physical modules created object based scheme for multiple interaction patterns using the same structure
    [prototype-physical modular.kicad_pcb]
2017-11-09 moved a couple of components around, updating the routing
    [prototype-physical modular.dsn, prototype-physical modular.kicad_pcb]
2017-11-10 optimize design rules, location of some components, added labels to every connector pin
    [BOM.ods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]
2017-11-12 new go at routing
    [prototype-physical modular.kicad_pcb, prototype-physical modular.sch]
2017-11-17 job files for pcb assembly
    [prototype-physical modular-B.Cu.gbl, prototype-physical modular-B.Mask.gbs, prototype-physical modular-B.SilkS.gbo, prototype-physical modular-Edge.Cuts.gm1, prototype-physical modular-F.Cu.gtl, prototype-physical modular-F.Mask.gts, prototype-physical modular-F.SilkS.gto, prototype-physical modular-NPTH.drl]
2017-11-17 add slot for capacitor in case reset doesn't work
    [prototype-physical modular.kicad_pcb, prototype-physical modular.sch]
2017-11-17 proposal for standard/korg jumper in midi terminals
    [prototype-physical modular.sch]
2017-11-17 manual route effort that will not be used
    [prototype-physical modular.dsn, prototype-physical modular.kicad_pcb, prototype-physical modular.sch]
2018-03-19 enclosure changes and new prints. Unknown changes
    [knob.stl, opaque.dxf, opaque_front.dxf, prototype-physical modular-B.Cu.dxf, prototype-physical modular-B.Mask.dxf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]
